andrempmattos/procsys-testsuite/instrumentation/som-exp-host/som-exp-host.kicad_pcb

## KiCad design instrumentation/som-exp-host/som-exp-host.kicad_pcb (2025-03-12)

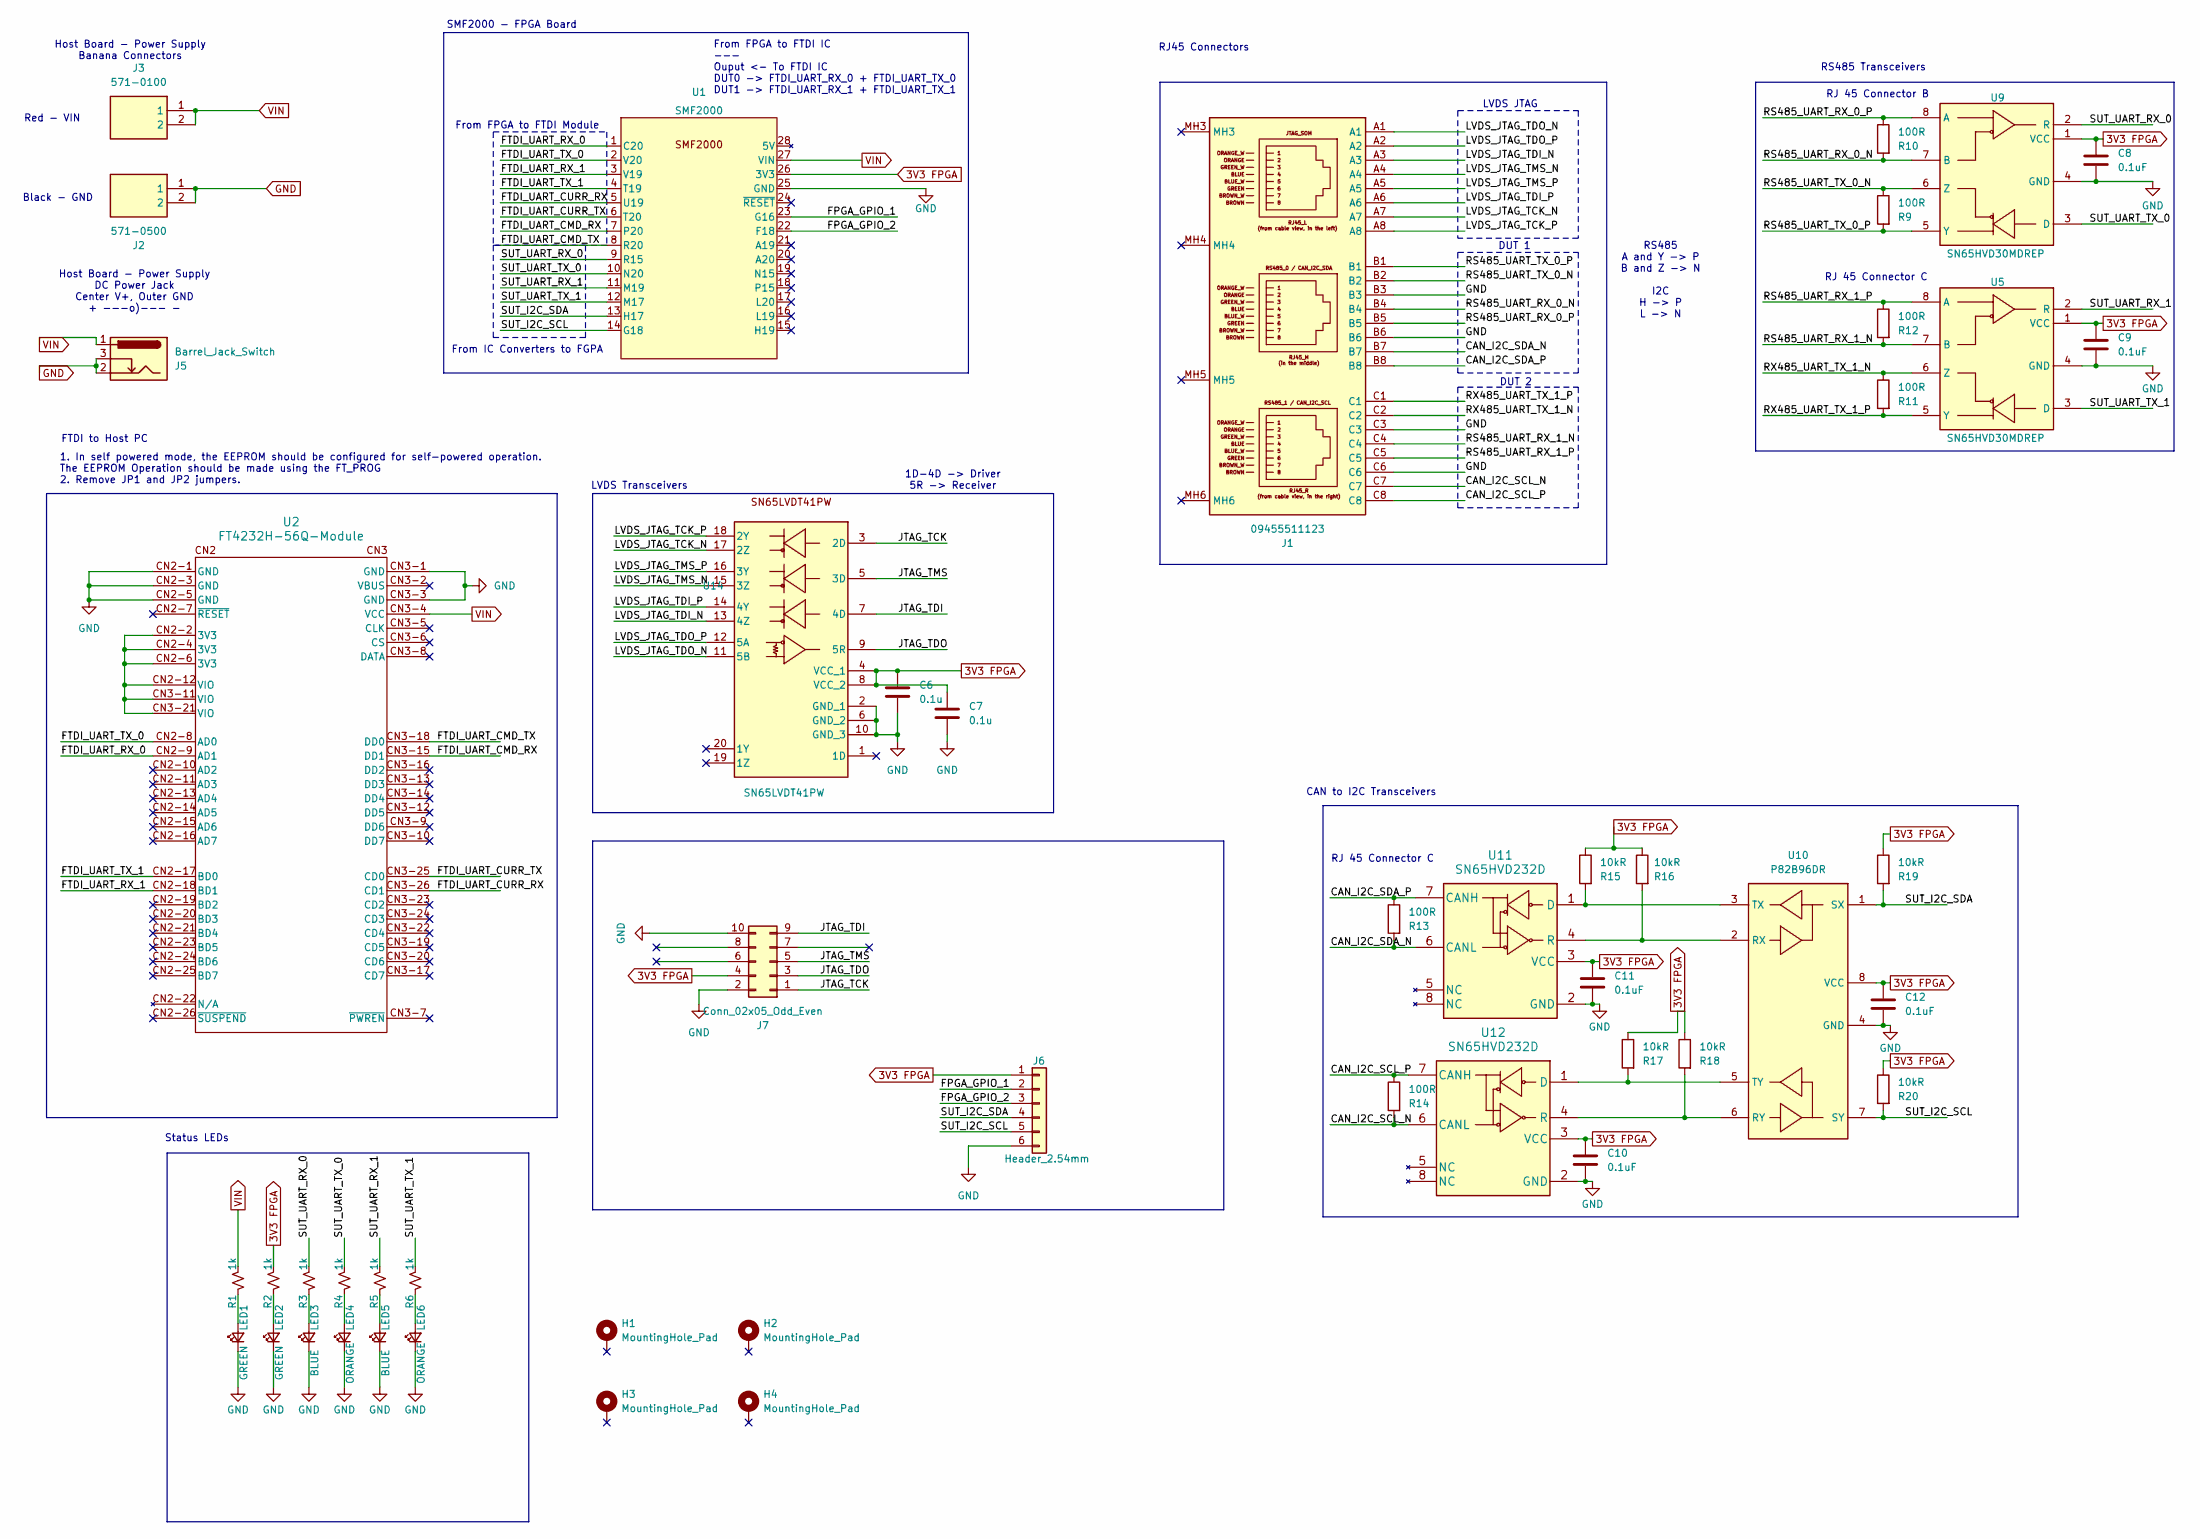
[picture p5: schematic som-exp-host.kicad_sch]

Parts:
C6, C7: 0.1u; C_0805_2012Metric_Pad1.18x1.45mm_HandSolder
C8, C9, C10, C11, C12: 0.1uF; C_0805_2012Metric_Pad1.18x1.45mm_HandSolder
H1, H2, H3, H4: MountingHole_Pad; MountingHole_2.7mm_Pad
J1: 09455511123; Mouser Part Number 617-09455511123
J2: 571-0500; 5710500; Mouser Part Number 164-6219
J3: 571-0100; 5710500; Mouser Part Number 164-6219
J5: Barrel_Jack_Switch; BarrelJack_GCT_DCJ200-10-A_Horizontal
J6: Header_2.54mm; PinHeader_1x06_P2.54mm_Vertical
J7: Conn_02x05_Odd_Even; IDC-Header_2x05_P2.54mm_Horizontal
LED1, LED2: GREEN; LED_0805_2012Metric_Pad1.15x1.40mm_HandSolder
LED3, LED5: BLUE; LED_0805_2012Metric_Pad1.15x1.40mm_HandSolder
LED4, LED6: ORANGE; LED_0805_2012Metric_Pad1.15x1.40mm_HandSolder
R1, R2, R3, R4, R5, R6: 1k; R_0805_2012Metric_Pad1.20x1.40mm_HandSolder
R9, R10, R11, R12, R13, R14: 100R; R_0805_2012Metric_Pad1.20x1.40mm_HandSolder
R15, R16, R17, R18, R19, R20: 10kR; R_0805_2012Metric_Pad1.20x1.40mm_HandSolder
U1: SMF2000
U2: FT4232H-56Q-Module
U5, U9: SN65HVD30MDREP; Manufacturer_Part_Number SN65HVD30MDREP
U10: P82B96DR; Mouser Part Number 595-P82B96DR
U11, U12: SN65HVD232D
U14: SN65LVDT41PW; Mouser Part Number 595-SN65LVDT41PW

Connections:
3V3 FPGA: C6.1, C7.1, C8.1, C9.1, C10.1, C11.1, C12.1, J6.1, J7.4, R2.1, R15.1, R16.1, R17.1, R18.1, R19.1, R20.1, U1.26 (3V3), U5.1 (VCC), U9.1 (VCC), U10.8 (VCC), U11.3 (VCC), U12.3 (VCC), U14.4 (VCC_1), U14.8 (VCC_2)
/CAN_I2C_SCL_N: J1.C7, R14.2, U12.6 (CANL)
/CAN_I2C_SCL_P: J1.C8, R14.1, U12.7 (CANH)
/CAN_I2C_SDA_N: J1.B7, R13.2, U11.6 (CANL)
/CAN_I2C_SDA_P: J1.B8, R13.1, U11.7 (CANH)
/FPGA_GPIO_1: J6.2, U1.23 (G16)
/FPGA_GPIO_2: J6.3, U1.22 (F18)
/FTDI_UART_CMD_RX: U1.7 (P20), U2.CN3-15 (DD1)
/FTDI_UART_CMD_TX: U1.8 (R20), U2.CN3-18 (DD0)
/FTDI_UART_CURR_RX: U1.5 (U19), U2.CN3-26 (CD1)
/FTDI_UART_CURR_TX: U1.6 (T20), U2.CN3-25 (CD0)
/FTDI_UART_RX_0: U1.1 (C20), U2.CN2-9 (AD1)
/FTDI_UART_RX_1: U1.3 (V19), U2.CN2-18 (BD1)
/FTDI_UART_TX_0: U1.2 (V20), U2.CN2-8 (AD0)
/FTDI_UART_TX_1: U1.4 (T19), U2.CN2-17 (BD0)
/JTAG_TCK: J7.1, U14.3 (2D)
/JTAG_TDI: J7.9, U14.7 (4D)
/JTAG_TDO: J7.3, U14.9 (5R)
/JTAG_TMS: J7.5, U14.5 (3D)
/LVDS_JTAG_TCK_N: J1.A7, U14.17 (2Z)
/LVDS_JTAG_TCK_P: J1.A8, U14.18 (2Y)
/LVDS_JTAG_TDI_N: J1.A3, U14.13 (4Z)
/LVDS_JTAG_TDI_P: J1.A6, U14.14 (4Y)
/LVDS_JTAG_TDO_N: J1.A1, U14.11 (5B)
/LVDS_JTAG_TDO_P: J1.A2, U14.12 (5A)
/LVDS_JTAG_TMS_N: J1.A4, U14.15 (3Z)
/LVDS_JTAG_TMS_P: J1.A5, U14.16 (3Y)
/RS485_UART_RX_0_N: J1.B4, R10.2, U9.7 (B)
/RS485_UART_RX_0_P: J1.B5, R10.1, U9.8 (A)
/RS485_UART_RX_1_N: J1.C4, R12.2, U5.7 (B)
/RS485_UART_RX_1_P: J1.C5, R12.1, U5.8 (A)
/RS485_UART_TX_0_N: J1.B2, R9.1, U9.6 (Z)
/RS485_UART_TX_0_P: J1.B1, R9.2, U9.5 (Y)
/RX485_UART_TX_1_N: J1.C2, R11.1, U5.6 (Z)
/RX485_UART_TX_1_P: J1.C1, R11.2, U5.5 (Y)
/SUT_I2C_SCL: J6.5, R20.2, U1.14 (G18), U10.7 (SY)
/SUT_I2C_SDA: J6.4, R19.2, U1.13 (H17), U10.1 (SX)
/SUT_UART_RX_0: R3.1, U1.9 (R15), U9.2 (R)
/SUT_UART_RX_1: R5.1, U1.11 (M19), U5.2 (R)
/SUT_UART_TX_0: R4.1, U1.10 (N20), U9.3 (D)
/SUT_UART_TX_1: R6.1, U1.12 (M17), U5.3 (D)
GND: C6.2, C7.2, C8.2, C9.2, C10.2, C11.2, C12.2, J1.B3, J1.B6, J1.C3, J1.C6, J2.1, J2.2, J5.2, J5.3, J6.6, J7.2, J7.10, LED1.1 (K), LED2.1 (K), LED3.1 (K), LED4.1 (K), LED5.1 (K), LED6.1 (K), U1.25 (GND), U2.CN2-1 (GND), U2.CN2-3 (GND), U2.CN2-5 (GND), U2.CN3-1 (GND), U2.CN3-3 (GND), U5.4 (GND), U9.4 (GND), U10.4 (GND), U11.2 (GND), U12.2 (GND), U14.2 (GND_1), U14.6 (GND_2), U14.10 (GND_3)
unnamed: LED1.2 (A), R1.2
unnamed: LED2.2 (A), R2.2
unnamed: LED3.2 (A), R3.2
unnamed: LED4.2 (A), R4.2
unnamed: LED5.2 (A), R5.2
unnamed: LED6.2 (A), R6.2
unnamed: U2.CN2-2 (3V3), U2.CN2-4 (3V3), U2.CN2-6 (3V3), U2.CN2-12 (VIO), U2.CN3-11 (VIO), U2.CN3-21 (VIO)
unnamed: R16.2, U10.2 (RX), U11.4 (R)
unnamed: R18.2, U10.6 (RY), U12.4 (R)
unnamed: R15.2, U10.3 (TX), U11.1 (D)
unnamed: R17.2, U10.5 (TY), U12.1 (D)
VIN: J3.1, J3.2, J5.1, R1.1, U1.27 (VIN), U2.CN3-4 (VCC)

Notes on the sheet:
RJ45 Connectors
Status LEDs
RJ 45 Connector B
Black - GND
SMF2000 - FPGA Board
1D-4D -> Driver 5R -> Receiver
1. In self powered mode, the EEPROM should be configured for self-powered operation. The EEPROM Operation should be made using the FT_PROG 2. Remove JP1 and JP2 jumpers.
Host Board - Power Supply DC Power Jack Center V+, Outer GND + ---o)--- -
DUT 2
RJ 45 Connector C
LVDS JTAG
From IC Converters to FGPA
RS485 A and Y -> P B and Z -> N I2C H -> P L -> N
Red - VIN
CAN to I2C Transceivers
LVDS Transceivers
FTDI to Host PC
Host Board - Power Supply Banana Connectors
From FPGA to FTDI IC --- Ouput <- To FTDI IC DUT0 -> FTDI_UART_RX_0 + FTDI_UART_TX_0 DUT1 -> FTDI_UART_RX_1 + FTDI_UART_TX_1
DUT 1
From FPGA to FTDI Module
RS485 Transceivers

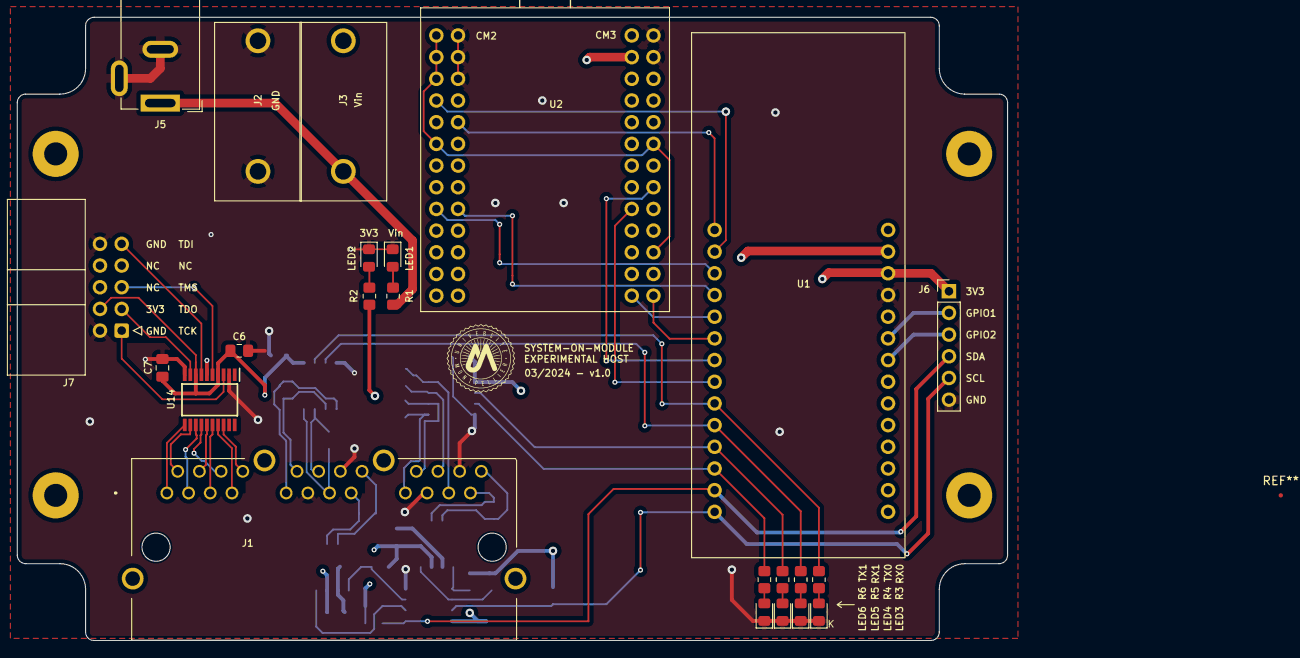
[picture p6: board som-exp-host.kicad_pcb from above]

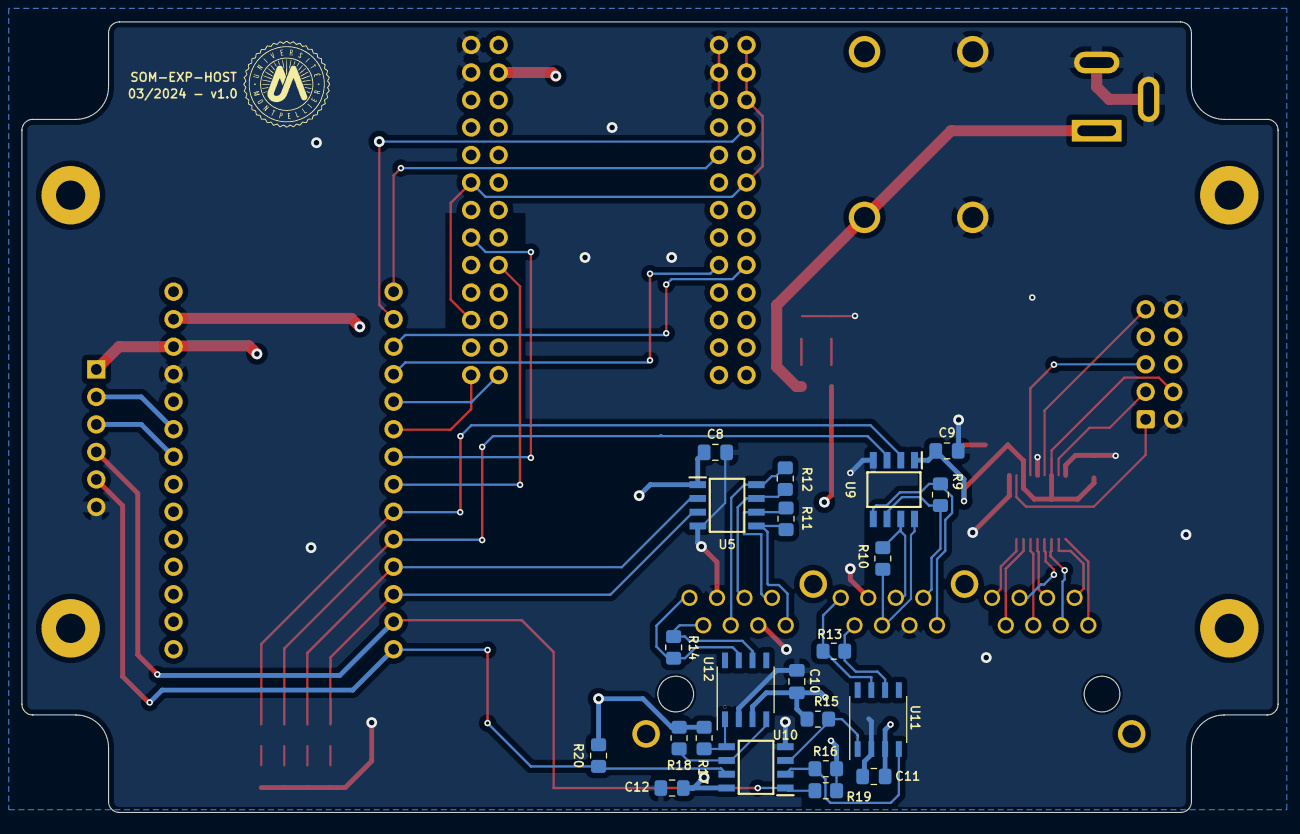
[picture p7: board som-exp-host.kicad_pcb from below]

Board: 4 copper layers, 116.0 x 73.0 mm, 49 parts (22 on the bottom side), 54 nets.
